vaxdatex/Polivoks-VCF/VCFPNL2_Montaza/VCFPNL2-layout.pdf

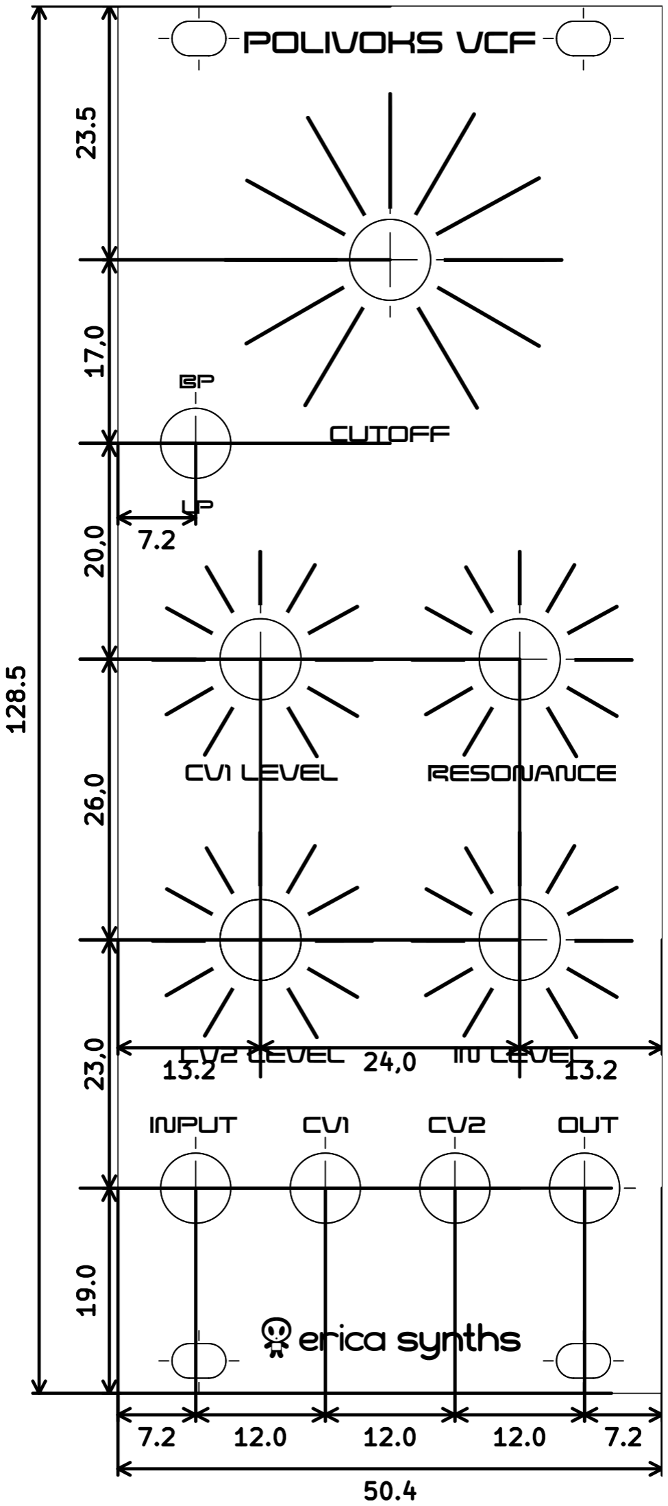
[picture p1: page 1]
