vaxdatex/Polivoks-VCF/VCFPNL2_Montaza/VCFPNL2-layout_noDim.pdf

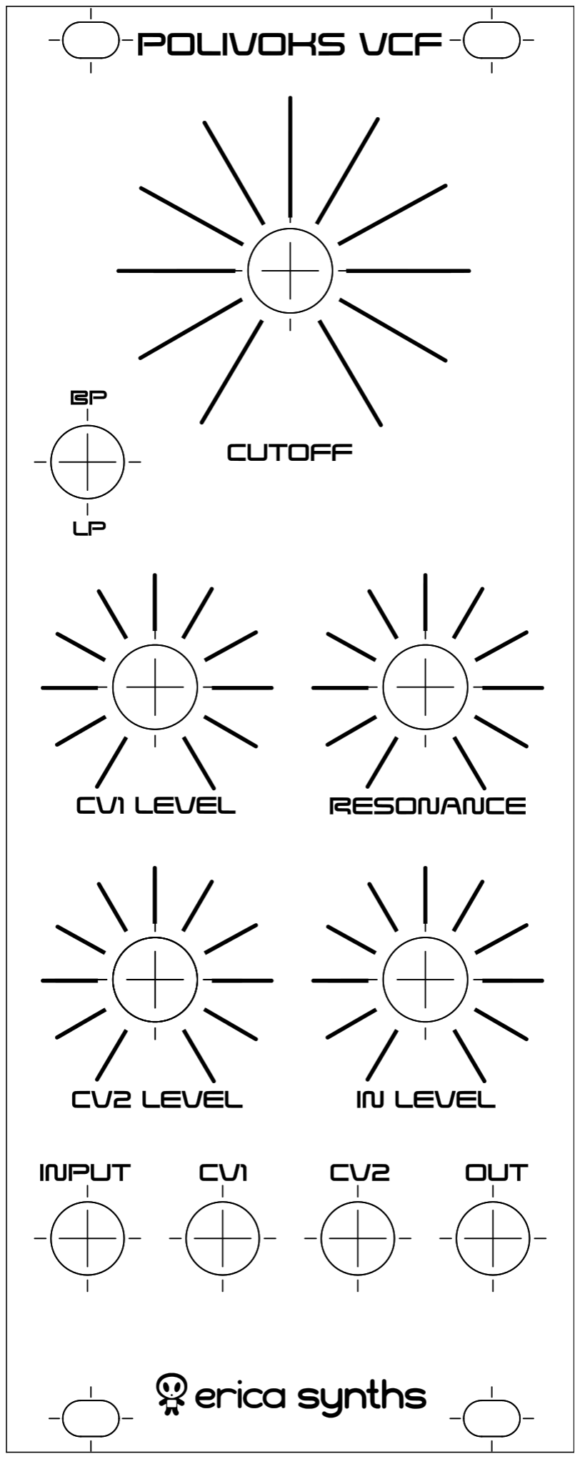
[picture p2: page 1]
