vaxdatex/Polivoks-VCF/Polivoks VCF assembly/DIY_Polivoks_VCF.pdf

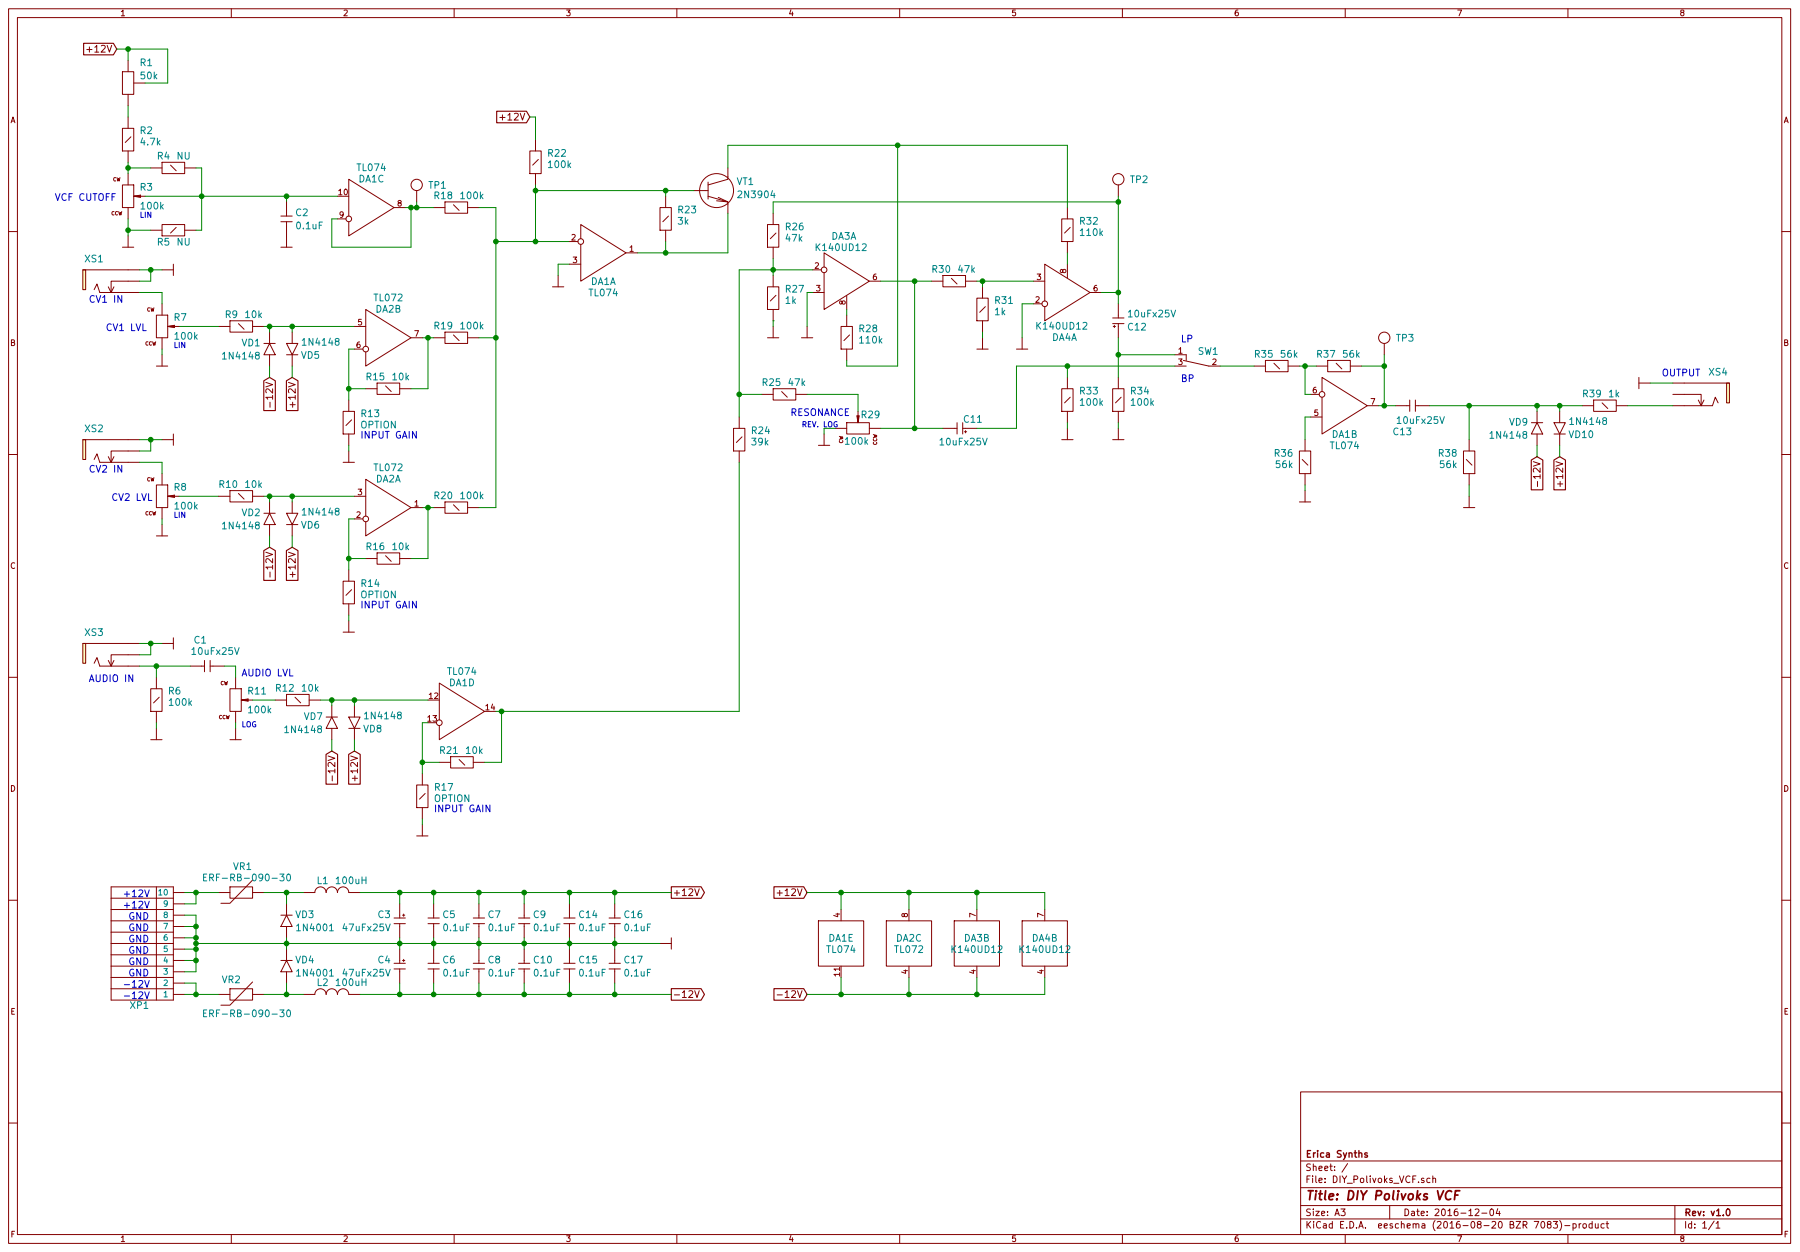
[picture p3: page 1]

+12V GND | 9

GND | 6
GND | 5
GND | 4
GND | 3
-12V | 2
-12V | 1

File: DIY_Polivoks_VCF.sch Sheet: / Erica Synths

Id: 1/1 Title: DIY Polivoks VCF
